OgnevOA/openprinttag_dryer_scale/hardware/carrier/netlist.md

# Carrier board netlist

Generated by `generate_netlist.py`. Do not edit by hand.

| Net | Connections |
| --- | --- |
| `+3V3` | C4.1, C5.1, C9.1, J3.10 +3V3, J4.1 +3V3, R10.2, R11.2, R13.2, R14.2, U1.12 3V3, U2.16 DVDD |
| `+5V` | C1.1, C2.1, C3.1, D1.1 K, D2.2 A, J3.1 +5V, Q1.3 C, U1.14 5V, U2.1 VSUP |
| `AGND` | C6.2, C7.2, C8.2, C11.2, C12.2, J2.2 E-, R4.2, R5.1, TP2.1, U2.5 AGND, U2.14 XI, U2.9 INB-, U2.15 RATE, U2.10 INB+ |
| `AVDD` | C7.1, C8.1, J2.1 E+, Q1.2 E, R3.1, TP1.1, U2.3 AVDD |
| `CELL_SIG+` | J2.3 SIG+, R6.1 |
| `CELL_SIG-` | J2.4 SIG-, R7.1 |
| `GND` | C1.2, C2.2, C3.2, C4.2, C5.2, C9.2, C13.2, D3.3 GND, J1.A12 GND, J1.B1 GND, J1.A1 GND, J1.B12 GND, J1.S1 SHIELD, J3.2 GND, J3.4 GND, J4.2 GND, R1.2, R2.2, R5.2, U1.13 GND |
| `HX_BASE` | Q1.1 B, U2.2 BASE |
| `HX_DOUT` | U1.1 D0/GPIO0, U2.12 DOUT |
| `HX_INA+` | C10.1, C11.1, R6.2, U2.8 INA+ |
| `HX_INA-` | C10.2, C12.1, R7.2, U2.7 INA- |
| `HX_SCK` | U1.2 D1/GPIO1, U2.11 PD_SCK |
| `HX_VBG` | C6.1, U2.6 VBG |
| `HX_VFB` | R3.2, R4.1, U2.4 VFB |
| `I2C_SCL` | J4.4 SCL, R14.1, U1.6 D5/GPIO23 |
| `I2C_SDA` | J4.3 SDA, R13.1, U1.5 D4/GPIO22 |
| `LED_DATA` | R12.1, U1.3 D2/GPIO2 |
| `LED_DATA_R` | D3.4 DIN, R12.2 |
| `NFC_BUSY` | J3.8 BUSY, U1.7 D6/GPIO16 |
| `NFC_NSS` | J3.7 NSS, R10.1, U1.4 D3/GPIO21 |
| `NFC_RST` | J3.9 RST, R11.1, U1.8 D7/GPIO17 |
| `SPI_MISO` | J3.6 MISO, U1.10 D9/GPIO20 |
| `SPI_MOSI` | R9.1, U1.11 D10/GPIO18 |
| `SPI_MOSI_R` | J3.5 MOSI, R9.2 |
| `SPI_SCK` | R8.1, U1.9 D8/GPIO19 |
| `SPI_SCK_R` | J3.3 SCK, R8.2 |
| `USB_CC1` | J1.A5 CC1, R1.1 |
| `USB_CC2` | J1.B5 CC2, R2.1 |
| `USB_VBUS_RAW` | F1.1, J1.A4 VBUS, J1.A9 VBUS, J1.B4 VBUS, J1.B9 VBUS |
| `VBUS` | D1.2 A, F1.2 |
| `VLED` | C13.1, D2.1 K, D3.1 VDD |

| Part | Value | Footprint |
| --- | --- | --- |
| C1 | 220u/10V | `Capacitor_SMD:CP_Elec_6.3x7.7` |
| C2 | 10u | `Capacitor_SMD:C_0603_1608Metric` |
| C3 | 100n | `Capacitor_SMD:C_0603_1608Metric` |
| C4 | 10u | `Capacitor_SMD:C_0603_1608Metric` |
| C5 | 100n | `Capacitor_SMD:C_0603_1608Metric` |
| C6 | 100n | `Capacitor_SMD:C_0603_1608Metric` |
| C7 | 10u | `Capacitor_SMD:C_0603_1608Metric` |
| C8 | 100n | `Capacitor_SMD:C_0603_1608Metric` |
| C9 | 100n | `Capacitor_SMD:C_0603_1608Metric` |
| C10 | 100n | `Capacitor_SMD:C_0603_1608Metric` |
| C11 | 10n | `Capacitor_SMD:C_0603_1608Metric` |
| C12 | 10n | `Capacitor_SMD:C_0603_1608Metric` |
| C13 | 100n | `Capacitor_SMD:C_0603_1608Metric` |
| D1 | SS34 | `Diode_SMD:D_SMA` |
| D2 | 1N4148W | `Diode_SMD:D_SOD-123` |
| D3 | WS2812B | `LED_SMD:LED_WS2812B_PLCC4_5.0x5.0mm_P3.2mm` |
| F1 | 500mA | `Fuse:Fuse_1206_3216Metric` |
| J1 | USB-C receptacle | `Connector_USB:USB_C_Receptacle_HRO_TYPE-C-31-M-12` |
| J2 | Load cell | `TerminalBlock:TerminalBlock_bornier-4_P5.08mm` |
| J3 | PN5180 ribbon | `Connector_IDC:IDC-Header_2x05_P2.54mm_Vertical` |
| J4 | Temp sensor | `Connector_PinHeader_2.54mm:PinHeader_1x04_P2.54mm_Vertical` |
| Q1 | BC817-40 | `Package_TO_SOT_SMD:SOT-23` |
| R1 | 5k1 | `Resistor_SMD:R_0603_1608Metric` |
| R2 | 5k1 | `Resistor_SMD:R_0603_1608Metric` |
| R3 | 20k | `Resistor_SMD:R_0603_1608Metric` |
| R4 | 8k2 | `Resistor_SMD:R_0603_1608Metric` |
| R5 | 0R | `Resistor_SMD:R_1206_3216Metric` |
| R6 | 1k | `Resistor_SMD:R_0603_1608Metric` |
| R7 | 1k | `Resistor_SMD:R_0603_1608Metric` |
| R8 | 33R | `Resistor_SMD:R_0603_1608Metric` |
| R9 | 33R | `Resistor_SMD:R_0603_1608Metric` |
| R10 | 10k | `Resistor_SMD:R_0603_1608Metric` |
| R11 | 10k | `Resistor_SMD:R_0603_1608Metric` |
| R12 | 330R | `Resistor_SMD:R_0603_1608Metric` |
| R13 | 4k7 | `Resistor_SMD:R_0603_1608Metric` |
| R14 | 4k7 | `Resistor_SMD:R_0603_1608Metric` |
| TP1 | AVDD | `TestPoint:TestPoint_Pad_D1.5mm` |
| TP2 | AGND | `TestPoint:TestPoint_Pad_D1.5mm` |
| U1 | XIAO ESP32-C6 | `Seeed_XIAO:XIAO_ESP32C6` |
| U2 | HX711 | `Package_SO:SOIC-16W_7.5x10.3mm_P1.27mm` |
