OgnevOA/openprinttag_dryer_scale/mechanical/preview/antenna_clamp.png

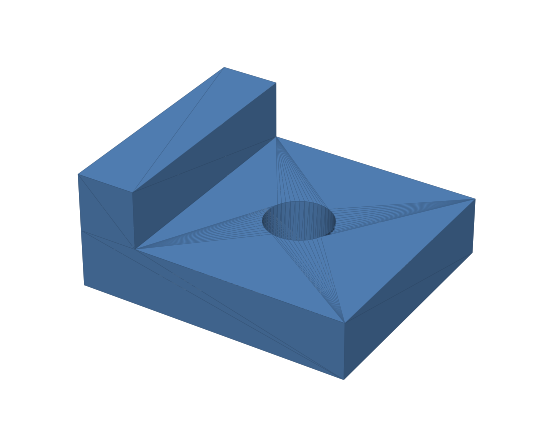
mechanical/preview/antenna_clamp.png
