OgnevOA/openprinttag_dryer_scale/mechanical/preview/cell_mount.png

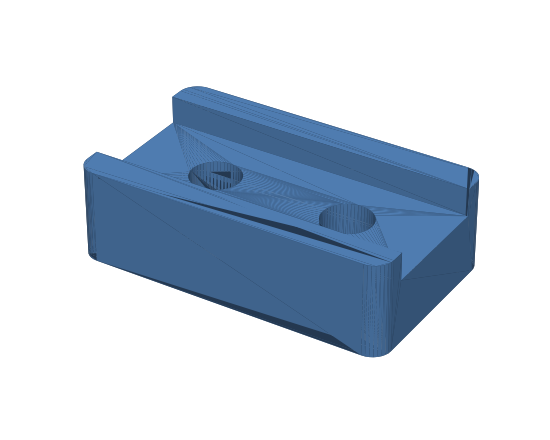
mechanical/preview/cell_mount.png
