OgnevOA/openprinttag_dryer_scale/mechanical/preview/overload_stop.png

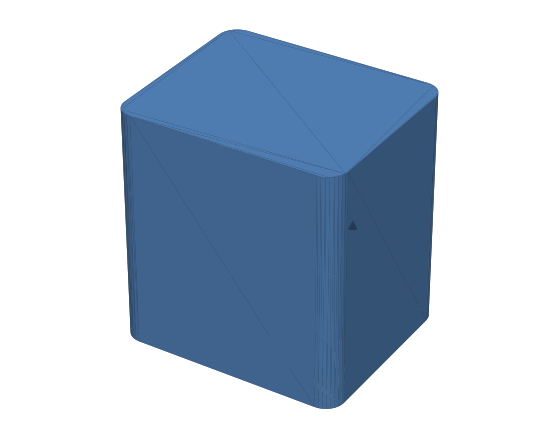
mechanical/preview/overload_stop.png
