OgnevOA/openprinttag_dryer_scale/mechanical/stl/cell_mount.stl

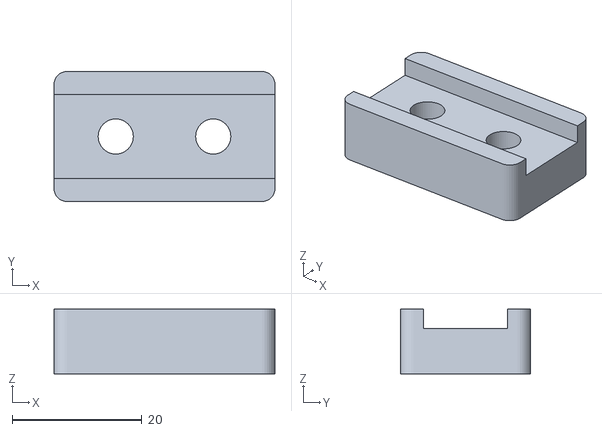
[picture p6: CAD file, 2026-11-01]
mechanical/stl/cell_mount.stl
34.0 x 20.0 x 10.0
