OgnevOA/openprinttag_dryer_scale/mechanical/stl/antenna_bracket.stl

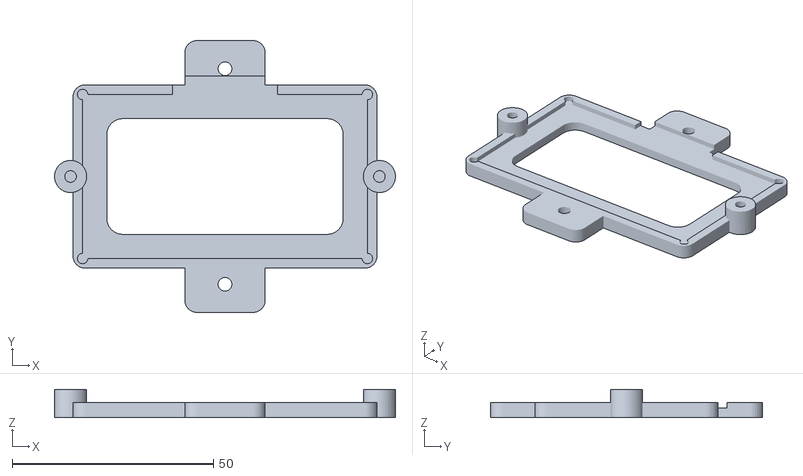
[picture p7: CAD file, 2026-11-01]
mechanical/stl/antenna_bracket.stl
84.8 x 67.6 x 7.00
