OgnevOA/openprinttag_dryer_scale/mechanical/stl/isolator_foot.stl

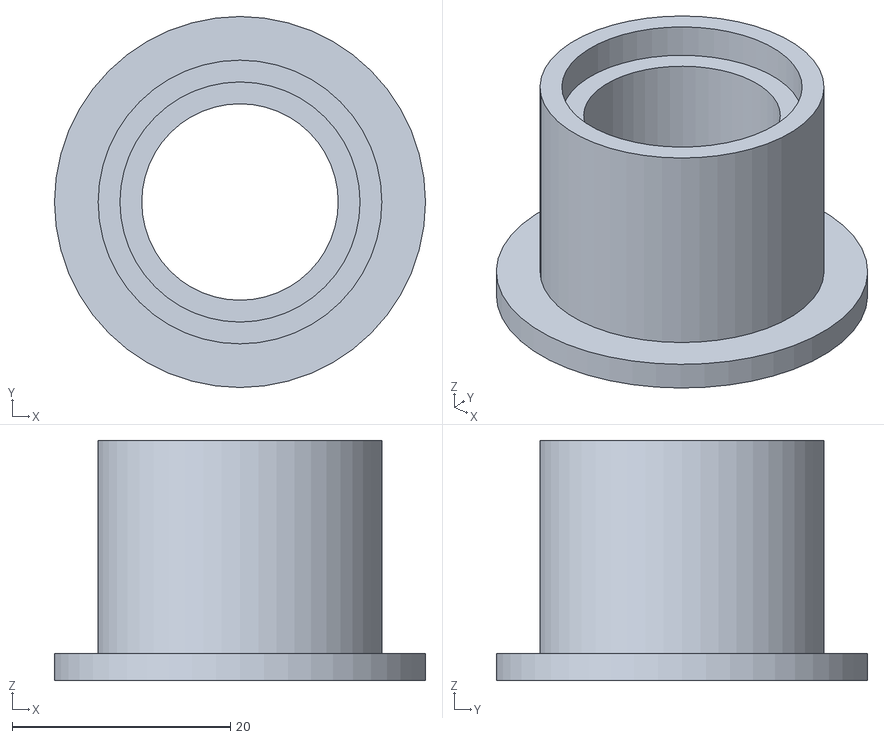
[picture p8: CAD file, 2026-11-01]
mechanical/stl/isolator_foot.stl
34.0 x 34.0 x 22.0
