OgnevOA/openprinttag_dryer_scale/mechanical/stl/overload_stop.stl

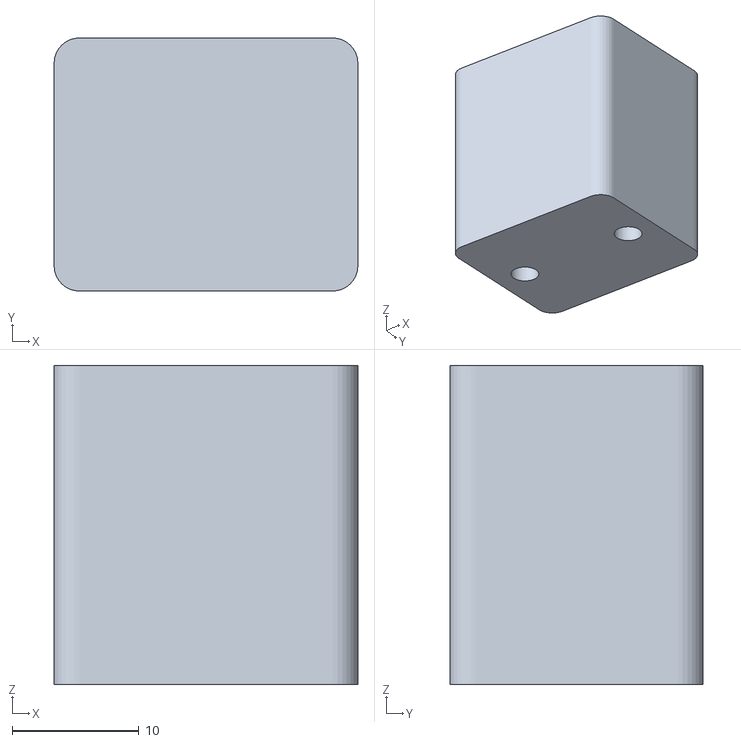
[picture p9: CAD file, 2026-11-01]
mechanical/stl/overload_stop.stl
24.0 x 20.0 x 25.2
