OgnevOA/openprinttag_dryer_scale/mechanical/stl/antenna_clamp.stl

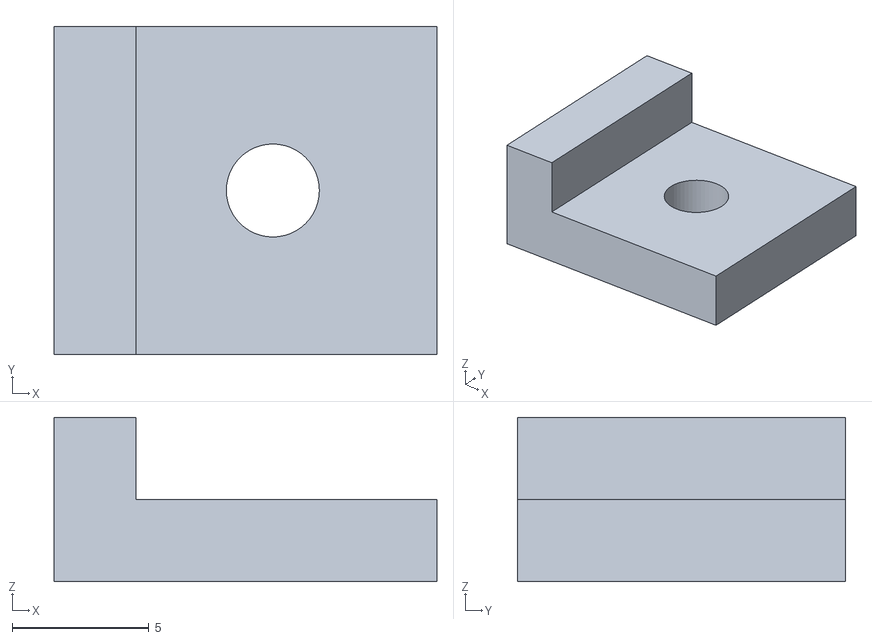
[picture p10: CAD file, 2026-11-01]
mechanical/stl/antenna_clamp.stl
14.0 x 12.0 x 6.00
