OgnevOA/openprinttag_dryer_scale/firmware/OpenPrintTagDryer/src/pn5180/PN5180.cpp

// NAME: PN5180.cpp
//
// DESC: Implementation of PN5180 class.
//
// Copyright (c) 2018 by Andreas Trappmann. All rights reserved.
//
// This file is part of the PN5180 library for the Arduino environment.
//
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
//#define DEBUG 1

#include <Arduino.h>
#include "PN5180.h"
#include "Debug.h"

// PN5180 1-Byte Direct Commands
// see 11.4.3.3 Host Interface Command List
#define PN5180_WRITE_REGISTER           (0x00)
#define PN5180_WRITE_REGISTER_OR_MASK   (0x01)
#define PN5180_WRITE_REGISTER_AND_MASK  (0x02)
#define PN5180_READ_REGISTER            (0x04)
#define PN5180_WRITE_EEPROM             (0x06)
#define PN5180_READ_EEPROM              (0x07)
#define PN5180_SEND_DATA                (0x09)
#define PN5180_READ_DATA                (0x0A)
#define PN5180_SWITCH_MODE              (0x0B)
#define PN5180_LOAD_RF_CONFIG           (0x11)
#define PN5180_RF_ON                    (0x16)
#define PN5180_RF_OFF                   (0x17)

uint8_t PN5180::readBuffer[508];

PN5180::PN5180(uint8_t SSpin, uint8_t BUSYpin, uint8_t RSTpin) {
  PN5180_NSS = SSpin;
  PN5180_BUSY = BUSYpin;
  PN5180_RST = RSTpin;

  /*
   * 11.4.1 Physical Host Interface
   * The interface of the PN5180 to a host microcontroller is based on a SPI interface,
   * extended by signal line BUSY. The maximum SPI speed is 7 Mbps and fixed to CPOL
   * = 0 and CPHA = 0.
   */
  // Settings for PN5180: 7Mbps, MSB first, SPI_MODE0 (CPOL=0, CPHA=0)
  PN5180_SPI_SETTINGS = SPISettings(7000000, MSBFIRST, SPI_MODE0);
}

void PN5180::begin(int8_t sckPin, int8_t misoPin, int8_t mosiPin,
                   uint32_t clockHz) {
  pinMode(PN5180_NSS, OUTPUT);
  pinMode(PN5180_BUSY, INPUT);
  pinMode(PN5180_RST, OUTPUT);

  digitalWrite(PN5180_NSS, HIGH); // disable
  digitalWrite(PN5180_RST, HIGH); // no reset

  PN5180_SPI_SETTINGS = SPISettings(clockHz, MSBFIRST, SPI_MODE0);

  if (sckPin >= 0 && misoPin >= 0 && mosiPin >= 0) {
    // Chip select stays under our own control, hence -1 for the SS argument.
    SPI.begin(sckPin, misoPin, mosiPin, -1);
  } else {
    SPI.begin();
  }
  PN5180DEBUG(F("SPI pinout: "));
  PN5180DEBUG(F("SS=")); PN5180DEBUG(SS);
  PN5180DEBUG(F(", MOSI=")); PN5180DEBUG(MOSI);
  PN5180DEBUG(F(", MISO=")); PN5180DEBUG(MISO);
  PN5180DEBUG(F(", SCK=")); PN5180DEBUG(SCK);
  PN5180DEBUG("\n");
}

void PN5180::end() {
  digitalWrite(PN5180_NSS, HIGH); // disable
  SPI.end();
}

/*
 * WRITE_REGISTER - 0x00
 * This command is used to write a 32-bit value (little endian) to a configuration register.
 * The address of the register must exist. If the condition is not fulfilled, an exception is
 * raised.
 */
bool PN5180::writeRegister(uint8_t reg, uint32_t value) {
  uint8_t *p = (uint8_t*)&value;

#ifdef DEBUG
  PN5180DEBUG(F("Write Register 0x"));
  PN5180DEBUG(formatHex(reg));
  PN5180DEBUG(F(", value (LSB first)=0x"));
  for (int i=0; i<4; i++) {
    PN5180DEBUG(formatHex(p[i]));
  }
  PN5180DEBUG("\n");
#endif

  /*
  For all 4 byte command parameter transfers (e.g. register values), the payload
  parameters passed follow the little endian approach (Least Significant Byte first).
   */
  uint8_t buf[6] = { PN5180_WRITE_REGISTER, reg, p[0], p[1], p[2], p[3] };

  SPI.beginTransaction(PN5180_SPI_SETTINGS);
  transceiveCommand(buf, 6);
  SPI.endTransaction();

  return true;
}

/*
 * WRITE_REGISTER_OR_MASK - 0x01
 * This command modifies the content of a register using a logical OR operation. The
 * content of the register is read and a logical OR operation is performed with the provided
 * mask. The modified content is written back to the register.
 * The address of the register must exist. If the condition is not fulfilled, an exception is
 * raised.
 */
bool PN5180::writeRegisterWithOrMask(uint8_t reg, uint32_t mask) {
  uint8_t *p = (uint8_t*)&mask;

#ifdef DEBUG
  PN5180DEBUG(F("Write Register 0x"));
  PN5180DEBUG(formatHex(reg));
  PN5180DEBUG(F(" with OR mask (LSB first)=0x"));
  for (int i=0; i<4; i++) {
    PN5180DEBUG(formatHex(p[i]));
  }
  PN5180DEBUG("\n");
#endif

  uint8_t buf[6] = { PN5180_WRITE_REGISTER_OR_MASK, reg, p[0], p[1], p[2], p[3] };

  SPI.beginTransaction(PN5180_SPI_SETTINGS);
  transceiveCommand(buf, 6);
  SPI.endTransaction();

  return true;
}

/*
 * WRITE _REGISTER_AND_MASK - 0x02
 * This command modifies the content of a register using a logical AND operation. The
 * content of the register is read and a logical AND operation is performed with the provided
 * mask. The modified content is written back to the register.
 * The address of the register must exist. If the condition is not fulfilled, an exception is
 * raised.
 */
bool PN5180::writeRegisterWithAndMask(uint8_t reg, uint32_t mask) {
  uint8_t *p = (uint8_t*)&mask;

#ifdef DEBUG
  PN5180DEBUG(F("Write Register 0x"));
  PN5180DEBUG(formatHex(reg));
  PN5180DEBUG(F(" with AND mask (LSB first)=0x"));
  for (int i=0; i<4; i++) {
    PN5180DEBUG(formatHex(p[i]));
  }
  PN5180DEBUG("\n");
#endif

  uint8_t buf[6] = { PN5180_WRITE_REGISTER_AND_MASK, reg, p[0], p[1], p[2], p[3] };

  SPI.beginTransaction(PN5180_SPI_SETTINGS);
  transceiveCommand(buf, 6);
  SPI.endTransaction();

  return true;
}

/*
 * READ_REGISTER - 0x04
 * This command is used to read the content of a configuration register. The content of the
 * register is returned in the 4 byte response.
 * The address of the register must exist. If the condition is not fulfilled, an exception is
 * raised.
 */
bool PN5180::readRegister(uint8_t reg, uint32_t *value) {
  PN5180DEBUG(F("Reading register 0x"));
  PN5180DEBUG(formatHex(reg));
  PN5180DEBUG(F("...\n"));

  uint8_t cmd[2] = { PN5180_READ_REGISTER, reg };

  SPI.beginTransaction(PN5180_SPI_SETTINGS);
  transceiveCommand(cmd, 2, (uint8_t*)value, 4);
  SPI.endTransaction();

  PN5180DEBUG(F("Register value=0x"));
  PN5180DEBUG(formatHex(*value));
  PN5180DEBUG("\n");

  return true;
}

/*
 * WRITE_EEPROM - 0x06
 */
 bool PN5180::writeEEPROM(uint8_t addr, uint8_t *data, int len) {
   if ((addr > 254) || ((addr+len) > 254)) {
     PN5180DEBUG(F("ERROR: Writing beyond addr 254!\n"));
     return false;
   }

   PN5180DEBUG(F("Writing to EEPROM at 0x"));
   PN5180DEBUG(formatHex(addr));
   PN5180DEBUG(F(", size="));
   PN5180DEBUG(len);
   PN5180DEBUG(F("...\n"));

   uint8_t buffer[len+2];
   buffer[0] = PN5180_WRITE_EEPROM;
   buffer[1] = addr;
   for (int i=0; i<len; i++) {
     buffer[2+i] = data[i];
   }

   SPI.beginTransaction(PN5180_SPI_SETTINGS);
   transceiveCommand(buffer, len+2);
   SPI.endTransaction();

   return true;
 }

/*
 * READ_EEPROM - 0x07
 * This command is used to read data from EEPROM memory area. The field 'Address'
 * indicates the start address of the read operation. The field Length indicates the number
 * of bytes to read. The response contains the data read from EEPROM (content of the
 * EEPROM); The data is read in sequentially increasing order starting with the given
 * address.
 * EEPROM Address must be in the range from 0 to 254, inclusive. Read operation must
 * not go beyond EEPROM address 254. If the condition is not fulfilled, an exception is
 * raised.
 */
bool PN5180::readEEprom(uint8_t addr, uint8_t *buffer, int len) {
  if ((addr > 254) || ((addr+len) > 254)) {
    PN5180DEBUG(F("ERROR: Reading beyond addr 254!\n"));
    return false;
  }

  PN5180DEBUG(F("Reading EEPROM at 0x"));
  PN5180DEBUG(formatHex(addr));
  PN5180DEBUG(F(", size="));
  PN5180DEBUG(len);
  PN5180DEBUG(F("...\n"));

  uint8_t cmd[3] = { PN5180_READ_EEPROM, addr, len };

  SPI.beginTransaction(PN5180_SPI_SETTINGS);
  transceiveCommand(cmd, 3, buffer, len);
  SPI.endTransaction();

#ifdef DEBUG
  PN5180DEBUG(F("EEPROM values: "));
  for (int i=0; i<len; i++) {
    PN5180DEBUG(formatHex(buffer[i]));
    PN5180DEBUG(" ");
  }
  PN5180DEBUG("\n");
#endif

  return true;
}

/*
 * SEND_DATA - 0x09
 * This command writes data to the RF transmission buffer and starts the RF transmission.
 * The parameter ‘Number of valid bits in last Byte’ indicates the exact number of bits to be
 * transmitted for the last byte (for non-byte aligned frames).
 * Precondition: Host shall configure the Transceiver by setting the register
 * SYSTEM_CONFIG.COMMAND to 0x3 before using the SEND_DATA command, as
 * the command SEND_DATA is only writing data to the transmission buffer and starts the
 * transmission but does not perform any configuration.
 * The size of ‘Tx Data’ field must be in the range from 0 to 260, inclusive (the 0 byte length
 * allows a symbol only transmission when the TX_DATA_ENABLE is cleared).‘Number of
 * valid bits in last Byte’ field must be in the range from 0 to 7. The command must not be
 * called during an ongoing RF transmission. Transceiver must be in ‘WaitTransmit’ state
 * with ‘Transceive’ command set. If the condition is not fulfilled, an exception is raised.
 */
bool PN5180::sendData(uint8_t *data, int len, uint8_t validBits) {
  if (len > 260) {
    PN5180DEBUG(F("ERROR: sendData with more than 260 bytes is not supported!\n"));
    return false;
  }

#ifdef DEBUG
  PN5180DEBUG(F("Send data (len="));
  PN5180DEBUG(len);
  PN5180DEBUG(F("):"));
  for (int i=0; i<len; i++) {
    PN5180DEBUG(" ");
    PN5180DEBUG(formatHex(data[i]));
  }
  PN5180DEBUG("\n");
#endif

  uint8_t buffer[len+2];
  buffer[0] = PN5180_SEND_DATA;
  buffer[1] = validBits; // number of valid bits of last byte are transmitted (0 = all bits are transmitted)
  for (int i=0; i<len; i++) {
    buffer[2+i] = data[i];
  }

  writeRegisterWithAndMask(SYSTEM_CONFIG, 0xfffffff8);  // Idle/StopCom Command
  writeRegisterWithOrMask(SYSTEM_CONFIG, 0x00000003);   // Transceive Command
  /*
   * Transceive command; initiates a transceive cycle.
   * Note: Depending on the value of the Initiator bit, a
   * transmission is started or the receiver is enabled
   * Note: The transceive command does not finish
   * automatically. It stays in the transceive cycle until
   * stopped via the IDLE/StopCom command
   */

  PN5180TransceiveStat transceiveState = getTransceiveState();
  if (PN5180_TS_WaitTransmit != transceiveState) {
    PN5180DEBUG(F("*** ERROR: Transceiver not in state WaitTransmit!?\n"));
    return false;
  }

  SPI.beginTransaction(PN5180_SPI_SETTINGS);
  transceiveCommand(buffer, len+2);
  SPI.endTransaction();

  return true;
}

/*
 * READ_DATA - 0x0A
 * This command reads data from the RF reception buffer, after a successful reception.
 * The RX_STATUS register contains the information to verify if the reception had been
 * successful. The data is available within the response of the command. The host controls
 * the number of bytes to be read via the SPI interface.
 * The RF data had been successfully received. In case the instruction is executed without
 * preceding an RF data reception, no exception is raised but the data read back from the
 * reception buffer is invalid. If the condition is not fulfilled, an exception is raised.
 */
uint8_t * PN5180::readData(int len, uint8_t *buffer /* = NULL */) {
  if (len > 508) {
    Serial.println(F("*** FATAL: Reading more than 508 bytes is not supported!"));
    return 0L;
  }
  if (NULL == buffer) {
    buffer = readBuffer;
  }

  PN5180DEBUG(F("Reading Data (len="));
  PN5180DEBUG(len);
  PN5180DEBUG(F(")...\n"));

  uint8_t cmd[2] = { PN5180_READ_DATA, 0x00 };

  SPI.beginTransaction(PN5180_SPI_SETTINGS);
  transceiveCommand(cmd, 2, buffer, len);
  SPI.endTransaction();

#ifdef DEBUG
  PN5180DEBUG(F("Data read: "));
  for (int i=0; i<len; i++) {
    PN5180DEBUG(formatHex(buffer[i]));
    PN5180DEBUG(" ");
  }
  PN5180DEBUG("\n");
#endif

  return readBuffer;
}

/*
 * LOAD_RF_CONFIG - 0x11
 * Parameter 'Transmitter Configuration' must be in the range from 0x0 - 0x1C, inclusive. If
 * the transmitter parameter is 0xFF, transmitter configuration is not changed.
 * Field 'Receiver Configuration' must be in the range from 0x80 - 0x9C, inclusive. If the
 * receiver parameter is 0xFF, the receiver configuration is not changed. If the condition is
 * not fulfilled, an exception is raised.
 * The transmitter and receiver configuration shall always be configured for the same
 * transmission/reception speed. No error is returned in case this condition is not taken into
 * account.
 *
 * Transmitter: RF   Protocol          Speed     Receiver: RF    Protocol    Speed
 * configuration                       (kbit/s)  configuration               (kbit/s)
 * byte (hex)                                    byte (hex)
 * ----------------------------------------------------------------------------------------------
 * ->0D              ISO 15693 ASK100  26        8D              ISO 15693   26
 *   0E              ISO 15693 ASK10   26        8E              ISO 15693   53
 */
bool PN5180::loadRFConfig(uint8_t txConf, uint8_t rxConf) {
  PN5180DEBUG(F("Load RF-Config: txConf="));
  PN5180DEBUG(formatHex(txConf));
  PN5180DEBUG(F(", rxConf="));
  PN5180DEBUG(formatHex(rxConf));
  PN5180DEBUG("\n");

  uint8_t cmd[3] = { PN5180_LOAD_RF_CONFIG, txConf, rxConf };

  SPI.beginTransaction(PN5180_SPI_SETTINGS);
  transceiveCommand(cmd, 3);
  SPI.endTransaction();

  return true;
}

/*
 * RF_ON - 0x16
 * This command is used to switch on the internal RF field. If enabled the TX_RFON_IRQ is
 * set after the field is switched on.
 */
bool PN5180::setRF_on() {
  PN5180DEBUG(F("Set RF ON\n"));

  uint8_t cmd[2] = { PN5180_RF_ON, 0x00 };

  SPI.beginTransaction(PN5180_SPI_SETTINGS);
  transceiveCommand(cmd, 2);
  SPI.endTransaction();

  if (!waitForIRQ(TX_RFON_IRQ_STAT)) return false; // wait for the field to set up
  clearIRQStatus(TX_RFON_IRQ_STAT);
  return true;
}

/*
 * RF_OFF - 0x17
 * This command is used to switch off the internal RF field. If enabled, the TX_RFOFF_IRQ
 * is set after the field is switched off.
 */
bool PN5180::setRF_off() {
  PN5180DEBUG(F("Set RF OFF\n"));

  uint8_t cmd[2] { PN5180_RF_OFF, 0x00 };

  SPI.beginTransaction(PN5180_SPI_SETTINGS);
  transceiveCommand(cmd, 2);
  SPI.endTransaction();

  if (!waitForIRQ(TX_RFOFF_IRQ_STAT)) return false; // wait for the field to shut down
  clearIRQStatus(TX_RFOFF_IRQ_STAT);
  return true;
}

//---------------------------------------------------------------------------------------------

/*
11.4.3.1 A Host Interface Command consists of either 1 or 2 SPI frames depending whether the
host wants to write or read data from the PN5180. An SPI Frame consists of multiple
bytes.

All commands are packed into one SPI Frame. An SPI Frame consists of multiple bytes.
No NSS toggles allowed during sending of an SPI frame.

For all 4 byte command parameter transfers (e.g. register values), the payload
parameters passed follow the little endian approach (Least Significant Byte first).

Direct Instructions are built of a command code (1 Byte) and the instruction parameters
(max. 260 bytes). The actual payload size depends on the instruction used.
Responses to direct instructions contain only a payload field (no header).
All instructions are bound to conditions. If at least one of the conditions is not fulfilled, an exception is
raised. In case of an exception, the IRQ line of PN5180 is asserted and corresponding interrupt
status register contain information on the exception.
*/

/*
 * A Host Interface Command consists of either 1 or 2 SPI frames depending whether the
 * host wants to write or read data from the PN5180. An SPI Frame consists of multiple
 * bytes.
 * All commands are packed into one SPI Frame. An SPI Frame consists of multiple bytes.
 * No NSS toggles allowed during sending of an SPI frame.
 * For all 4 byte command parameter transfers (e.g. register values), the payload
 * parameters passed follow the little endian approach (Least Significant Byte first).
 * The BUSY line is used to indicate that the system is BUSY and cannot receive any data
 * from a host. Recommendation for the BUSY line handling by the host:
 * 1. Assert NSS to Low
 * 2. Perform Data Exchange
 * 3. Wait until BUSY is high
 * 4. Deassert NSS
 * 5. Wait until BUSY is low
 * If there is a parameter error, the IRQ is set to ACTIVE and a GENERAL_ERROR_IRQ is set.
 */
bool PN5180::transceiveCommand(uint8_t *sendBuffer, size_t sendBufferLen, uint8_t *recvBuffer, size_t recvBufferLen) {
#ifdef DEBUG
  PN5180DEBUG(F("Sending SPI frame: '"));
  for (uint8_t i=0; i<sendBufferLen; i++) {
    if (i>0) PN5180DEBUG(" ");
    PN5180DEBUG(formatHex(sendBuffer[i]));
  }
  PN5180DEBUG("'\n");
#endif

  // 0.
  if (!waitBusy(LOW)) return false; // wait until busy is low
  // 1.
  digitalWrite(PN5180_NSS, LOW); delay(2);
  // 2.
  for (uint8_t i=0; i<sendBufferLen; i++) {
    SPI.transfer(sendBuffer[i]);
  }
  // 3.
  if (!waitBusy(HIGH)) { digitalWrite(PN5180_NSS, HIGH); return false; }
  // 4.
  digitalWrite(PN5180_NSS, HIGH); delay(1);
  // 5.
  if (!waitBusy(LOW)) return false; // wait until BUSY is low

  // check, if write-only
  //
  if ((0 == recvBuffer) || (0 == recvBufferLen)) return true;
  PN5180DEBUG(F("Receiving SPI frame...\n"));

  // 1.
  digitalWrite(PN5180_NSS, LOW); delay(2);
  // 2.
  for (uint8_t i=0; i<recvBufferLen; i++) {
    recvBuffer[i] = SPI.transfer(0xff);
  }
  // 3.
  if (!waitBusy(HIGH)) { digitalWrite(PN5180_NSS, HIGH); return false; }
  // 4.
  digitalWrite(PN5180_NSS, HIGH); delay(1);
  // 5.
  if (!waitBusy(LOW)) return false; // wait until BUSY is low

#ifdef DEBUG
  PN5180DEBUG(F("Received: "));
  for (uint8_t i=0; i<recvBufferLen; i++) {
    if (i > 0) PN5180DEBUG(" ");
    PN5180DEBUG(formatHex(recvBuffer[i]));
  }
  PN5180DEBUG("'\n");
#endif

  return true;
}

/*
 * Waits for the BUSY line to reach the requested level, giving up after
 * `timeoutMs`. Local addition: see the modification note in PN5180.h.
 */
bool PN5180::waitBusy(int level, uint32_t timeoutMs) {
  const uint32_t deadline = millis() + timeoutMs;
  while (level != digitalRead(PN5180_BUSY)) {
    if ((int32_t)(millis() - deadline) >= 0) {
      lastTimeout = true;
      return false;
    }
  }
  return true;
}

bool PN5180::waitForIRQ(uint32_t mask, uint32_t timeoutMs) {
  const uint32_t deadline = millis() + timeoutMs;
  while (mask != (mask & getIRQStatus())) {
    if ((int32_t)(millis() - deadline) >= 0) {
      lastTimeout = true;
      return false;
    }
    delay(1);
  }
  return true;
}

/*
 * Reset NFC device
 */
bool PN5180::reset() {
  lastTimeout = false;
  digitalWrite(PN5180_RST, LOW);  // at least 10us required
  delay(10);
  digitalWrite(PN5180_RST, HIGH); // 2ms to ramp up required
  delay(10);

  if (!waitForIRQ(IDLE_IRQ_STAT)) return false; // wait for system to start up

  clearIRQStatus(0xffffffff); // clear all flags
  return true;
}

/**
 * @name  getInterrrupt
 * @desc  read interrupt status register and clear interrupt status
 */
uint32_t PN5180::getIRQStatus() {
  PN5180DEBUG(F("Read IRQ-Status register...\n"));

  uint32_t irqStatus;
  readRegister(IRQ_STATUS, &irqStatus);

  PN5180DEBUG(F("IRQ-Status=0x"));
  PN5180DEBUG(formatHex(irqStatus));
  PN5180DEBUG("\n");

  return irqStatus;
}

bool PN5180::clearIRQStatus(uint32_t irqMask) {
  PN5180DEBUG(F("Clear IRQ-Status with mask=x"));
  PN5180DEBUG(formatHex(irqMask));
  PN5180DEBUG("\n");

  return writeRegister(IRQ_CLEAR, irqMask);
}

/*
 * Get TRANSCEIVE_STATE from RF_STATUS register
 */
#ifdef DEBUG
extern void showIRQStatus(uint32_t);
#endif

PN5180TransceiveStat PN5180::getTransceiveState() {
  PN5180DEBUG(F("Get Transceive state...\n"));

  uint32_t rfStatus;
  if (!readRegister(RF_STATUS, &rfStatus)) {
#ifdef DEBUG
    showIRQStatus(getIRQStatus());
#endif
    PN5180DEBUG(F("ERROR reading RF_STATUS register.\n"));
    return PN5180TransceiveStat(0);
  }

  /*
   * TRANSCEIVE_STATEs:
   *  0 - idle
   *  1 - wait transmit
   *  2 - transmitting
   *  3 - wait receive
   *  4 - wait for data
   *  5 - receiving
   *  6 - loopback
   *  7 - reserved
   */
  uint8_t state = ((rfStatus >> 24) & 0x07);
  PN5180DEBUG(F("TRANSCEIVE_STATE=0x"));
  PN5180DEBUG(formatHex(state));
  PN5180DEBUG("\n");

  return PN5180TransceiveStat(state);
}
