OgnevOA/openprinttag_dryer_scale/firmware/OpenPrintTagDryer/src/pn5180/PN5180.h

// NAME: PN5180.h
//
// DESC: NFC Communication with NXP Semiconductors PN5180 module for Arduino.
//
// Copyright (c) 2018 by Andreas Trappmann. All rights reserved.
//
// This file is part of the PN5180 library for the Arduino environment.
//
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
// ---------------------------------------------------------------------------
// LOCAL MODIFICATIONS for the OpenPrintTag dryer project (see ../../../README):
//
//  * begin() takes explicit SPI pins and a clock rate, because the ESP32-C6
//    needs the bus routed to the XIAO header and the reader sits on a ribbon
//    cable that will not take 7 MHz.
//  * Every wait on the BUSY line and on an IRQ flag is bounded by a timeout.
//    Upstream spins forever, which turns an unplugged or unpowered reader into
//    a watchdog reboot loop on a permanently installed device.
//  * reset() reports success instead of returning void.
//
// These files remain LGPL-2.1; see COPYING.LESSER.
// ---------------------------------------------------------------------------
//
#ifndef PN5180_H
#define PN5180_H

#include <SPI.h>

// PN5180 Registers
#define SYSTEM_CONFIG       (0x00)
#define IRQ_ENABLE          (0x01)
#define IRQ_STATUS          (0x02)
#define IRQ_CLEAR           (0x03)
#define TRANSCEIVE_CONTROL  (0x04)
#define TIMER1_RELOAD       (0x0c)
#define TIMER1_CONFIG       (0x0f)
#define RX_WAIT_CONFIG      (0x11)
#define CRC_RX_CONFIG       (0x12)
#define RX_STATUS           (0x13)
#define CRC_TX_CONFIG       (0x19)
#define RF_STATUS           (0x1d)
#define SYSTEM_STATUS       (0x24)
#define TEMP_CONTROL        (0x25)

// PN5180 EEPROM Addresses
#define DIE_IDENTIFIER      (0x00)
#define PRODUCT_VERSION     (0x10)
#define FIRMWARE_VERSION    (0x12)
#define EEPROM_VERSION      (0x14)
#define IRQ_PIN_CONFIG      (0x1A)

enum PN5180TransceiveStat {
  PN5180_TS_Idle = 0,
  PN5180_TS_WaitTransmit = 1,
  PN5180_TS_Transmitting = 2,
  PN5180_TS_WaitReceive = 3,
  PN5180_TS_WaitForData = 4,
  PN5180_TS_Receiving = 5,
  PN5180_TS_LoopBack = 6,
  PN5180_TS_RESERVED = 7
};

// PN5180 IRQ_STATUS
#define RX_IRQ_STAT         (1<<0)  // End of RF rececption IRQ
#define TX_IRQ_STAT         (1<<1)  // End of RF transmission IRQ
#define IDLE_IRQ_STAT       (1<<2)  // IDLE IRQ
#define RFOFF_DET_IRQ_STAT  (1<<6)  // RF Field OFF detection IRQ
#define RFON_DET_IRQ_STAT   (1<<7)  // RF Field ON detection IRQ
#define TX_RFOFF_IRQ_STAT   (1<<8)  // RF Field OFF in PCD IRQ
#define TX_RFON_IRQ_STAT    (1<<9)  // RF Field ON in PCD IRQ
#define RX_SOF_DET_IRQ_STAT (1<<14) // RF SOF Detection IRQ

class PN5180 {
private:
  uint8_t PN5180_NSS;   // active low
  uint8_t PN5180_BUSY;
  uint8_t PN5180_RST;

  SPISettings PN5180_SPI_SETTINGS;
  static uint8_t readBuffer[508];

public:
  PN5180(uint8_t SSpin, uint8_t BUSYpin, uint8_t RSTpin);

  // Pass -1 for the pins to keep the board's default SPI mapping.
  void begin(int8_t sckPin = -1, int8_t misoPin = -1, int8_t mosiPin = -1,
             uint32_t clockHz = 7000000);
  void end();

  // How long any single wait on BUSY or on an IRQ flag may take before the
  // operation is abandoned. A healthy PN5180 answers in microseconds.
  static const uint32_t BUSY_TIMEOUT_MS = 50;
  static const uint32_t IRQ_TIMEOUT_MS = 100;

  // True when the last operation gave up waiting for the reader, which means
  // the reader is unreachable rather than the tag being absent.
  bool timedOut() const { return lastTimeout; }

  /*
   * PN5180 direct commands with host interface
   */
public:
  /* cmd 0x00 */
  bool writeRegister(uint8_t reg, uint32_t value);
  /* cmd 0x01 */
  bool writeRegisterWithOrMask(uint8_t addr, uint32_t mask);
  /* cmd 0x02 */
  bool writeRegisterWithAndMask(uint8_t addr, uint32_t mask);

  /* cmd 0x04 */
  bool readRegister(uint8_t reg, uint32_t *value);

  /* cmd 0x06 */
  bool writeEEPROM(uint8_t addr, uint8_t *data, int len);

  /* cmd 0x07 */
  bool readEEprom(uint8_t addr, uint8_t *buffer, int len);

  /* cmd 0x09 */
  bool sendData(uint8_t *data, int len, uint8_t validBits = 0);
  /* cmd 0x0a */
  uint8_t * readData(int len, uint8_t *buffer = NULL);

  /* cmd 0x11 */
  bool loadRFConfig(uint8_t txConf, uint8_t rxConf);

  /* cmd 0x16 */
  bool setRF_on();
  /* cmd 0x17 */
  bool setRF_off();

  /*
   * Helper functions
   */
public:
  bool reset();

  uint32_t getIRQStatus();
  bool clearIRQStatus(uint32_t irqMask);

  // Waits for every bit in `mask` to appear in IRQ_STATUS. False on timeout.
  bool waitForIRQ(uint32_t mask, uint32_t timeoutMs = IRQ_TIMEOUT_MS);

  PN5180TransceiveStat getTransceiveState();

  /*
   * Private methods, called within an SPI transaction
   */
protected:
  bool transceiveCommand(uint8_t *sendBuffer, size_t sendBufferLen, uint8_t *recvBuffer = 0, size_t recvBufferLen = 0);

  // Waits for BUSY to reach `level` (HIGH or LOW). False on timeout.
  bool waitBusy(int level, uint32_t timeoutMs = BUSY_TIMEOUT_MS);

  bool lastTimeout = false;

};

#endif /* PN5180_H */
