OgnevOA/openprinttag_dryer_scale/firmware/OpenPrintTagDryer/src/pn5180/PN5180ISO15693.h

// NAME: PN5180ISO15693.h
//
// DESC: ISO15693 protocol on NXP Semiconductors PN5180 module for Arduino.
//
// Copyright (c) 2018 by Andreas Trappmann. All rights reserved.
//
// This file is part of the PN5180 library for the Arduino environment.
//
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
// ---------------------------------------------------------------------------
// LOCAL MODIFICATIONS for the OpenPrintTag dryer project:
//
//  * The wait for a tag's response is bounded (ISO15693_RX_TIMEOUT_MS).
//  * issueISO15693Command is protected rather than private, so the project's
//    own subclass can add the Read Multiple Blocks command without forking the
//    whole file. Reading a 79-block tag one block at a time takes over a
//    second; in chunks it takes about a tenth of that.
//
// These files remain LGPL-2.1; see COPYING.LESSER.
// ---------------------------------------------------------------------------
//
#ifndef PN5180ISO15693_H
#define PN5180ISO15693_H

#include "PN5180.h"

// How long to wait for a tag to finish answering before treating it as gone.
#define ISO15693_RX_TIMEOUT_MS  (200)

enum ISO15693ErrorCode {
  EC_NO_CARD = -1,
  ISO15693_EC_OK = 0,
  ISO15693_EC_NOT_SUPPORTED = 0x01,
  ISO15693_EC_NOT_RECOGNIZED = 0x02,
  ISO15693_EC_OPTION_NOT_SUPPORTED = 0x03,
  ISO15693_EC_UNKNOWN_ERROR = 0x0f,
  ISO15693_EC_BLOCK_NOT_AVAILABLE = 0x10,
  ISO15693_EC_BLOCK_ALREADY_LOCKED = 0x11,
  ISO15693_EC_BLOCK_IS_LOCKED = 0x12,
  ISO15693_EC_BLOCK_NOT_PROGRAMMED = 0x13,
  ISO15693_EC_BLOCK_NOT_LOCKED = 0x14,
  ISO15693_EC_CUSTOM_CMD_ERROR = 0xA0
};

class PN5180ISO15693 : public PN5180 {

public:
  PN5180ISO15693(uint8_t SSpin, uint8_t BUSYpin, uint8_t RSTpin);
  
protected:
  ISO15693ErrorCode issueISO15693Command(uint8_t *cmd, uint8_t cmdLen, uint8_t **resultPtr);
public:
  ISO15693ErrorCode getInventory(uint8_t *uid);

  ISO15693ErrorCode readSingleBlock(uint8_t *uid, uint8_t blockNo, uint8_t *blockData, uint8_t blockSize);
  ISO15693ErrorCode writeSingleBlock(uint8_t *uid, uint8_t blockNo, uint8_t *blockData, uint8_t blockSize);

  ISO15693ErrorCode getSystemInfo(uint8_t *uid, uint8_t *blockSize, uint8_t *numBlocks);
   
  // ICODE SLIX2 specific commands, see https://www.nxp.com/docs/en/data-sheet/SL2S2602.pdf
  ISO15693ErrorCode getRandomNumber(uint8_t *randomData);
  ISO15693ErrorCode setPassword(uint8_t *password, uint8_t *random);
  ISO15693ErrorCode writePassword(uint8_t *password, uint8_t *uid);
  ISO15693ErrorCode enablePrivacy(uint8_t *password, uint8_t *random);
  ISO15693ErrorCode unlockICODESLIX2(uint8_t *password);
  ISO15693ErrorCode lockICODESLIX2(uint8_t *password);
  ISO15693ErrorCode newpasswordICODESLIX2(uint8_t *newpassword, uint8_t *oldpassword, uint8_t *uid);
  /*
   * Helper functions
   */
public:   
  bool setupRF();
  const __FlashStringHelper *strerror(ISO15693ErrorCode errno);
    
};

#endif /* PN5180ISO15693_H */
