OgnevOA/openprinttag_dryer_scale/tests/test_logic.cpp

// Host tests for the firmware logic that does not need a radio: the HX711
// driver against a simulated converter, the calibration and weight maths, the
// spool state derivation, the material presets, and the reader's behaviour when
// nothing answers on the SPI bus.

#include <ctype.h>
#include <math.h>
#include <stdio.h>
#include <stdlib.h>
#include <string.h>

#include <string>
#include <vector>

// The fake Spoolman lives behind the HTTP client stub, so the tests reach it
// the same way the firmware reaches the real one.
#include <HTTPClient.h>

#include "../firmware/OpenPrintTagDryer/src/App.h"
#include "../firmware/OpenPrintTagDryer/src/DriftLog.h"
#include "../firmware/OpenPrintTagDryer/src/Ds18b20.h"
#include "../firmware/OpenPrintTagDryer/src/HaMqtt.h"
#include "../firmware/OpenPrintTagDryer/src/NfcManager.h"
#include "../firmware/OpenPrintTagDryer/src/PrusamentPresets.h"
#include "../firmware/OpenPrintTagDryer/src/ScaleManager.h"
#include "../firmware/OpenPrintTagDryer/src/SpoolState.h"
#include "../firmware/OpenPrintTagDryer/src/SpoolmanClient.h"
#include "../firmware/OpenPrintTagDryer/src/WebPortal.h"
#include "../firmware/OpenPrintTagDryer/src/WriteBackPolicy.h"
#include "../firmware/OpenPrintTagDryer/src/openprinttag/opt_enums.h"

namespace {

int gChecks = 0;
int gFailures = 0;
const char *gCurrentTest = "";

void fail(const std::string &what, const std::string &detail) {
    ++gFailures;
    printf("  FAIL %s: %s\n        %s\n", gCurrentTest, what.c_str(),
           detail.c_str());
}

void check(bool condition, const std::string &what,
           const std::string &detail = "") {
    ++gChecks;
    if (!condition) {
        fail(what, detail);
    }
}

void checkEqualInt(long long actual, long long expected,
                   const std::string &what) {
    ++gChecks;
    if (actual != expected) {
        char buffer[128];
        snprintf(buffer, sizeof(buffer), "expected %lld, got %lld", expected,
                 actual);
        fail(what, buffer);
    }
}

void checkNear(double actual, double expected, double tolerance,
               const std::string &what) {
    ++gChecks;
    if (fabs(actual - expected) > tolerance) {
        char buffer[160];
        snprintf(buffer, sizeof(buffer), "expected %g +/- %g, got %g", expected,
                 tolerance, actual);
        fail(what, buffer);
    }
}

// Feeds the scale a steady value until it produces measurements.
void feedScale(ScaleManager &scale, long counts, int measurements) {
    hostio::setHx711Value(counts, true);
    int produced = 0;
    for (int guard = 0; guard < 20000 && produced < measurements; ++guard) {
        hostio::hx711().ready = true;  // a fresh conversion is always waiting
        if (scale.loop(hostio::now())) {
            ++produced;
        }
        hostio::advance(1);
    }
    check(produced == measurements, "scale produced the requested measurements",
          std::to_string(produced) + " of " + std::to_string(measurements));
}

void startScale(ScaleManager &scale) {
    hostio::attachHx711(PIN_HX711_DOUT, PIN_HX711_SCK);
    hostio::setHx711Value(100000, true);
    check(scale.begin(), "scale begins with a responding converter");
}

// ---------------------------------------------------------------------------

void testHx711Driver() {
    gCurrentTest = "hx711 driver";
    hostio::reset();

    ScaleManager scale;
    startScale(scale);

    // The driver must reproduce the converter's 24-bit two's complement output
    // exactly, including the sign, and clock a 25th pulse to keep channel A at
    // gain 128.
    struct Case {
        long value;
        const char *label;
    };
    const Case cases[] = {
        {123456, "positive mid-range"},
        {0x7FFFFF, "largest positive"},
        {-123456, "negative mid-range"},
        {-0x800000, "largest negative"},
    };

    for (const Case &testCase : cases) {
        hostio::setHx711Value(testCase.value, true);
        const uint32_t before = hostio::hx711().conversions;
        // 15 samples make one measurement; all of them read the same value.
        feedScale(scale, testCase.value, 1);
        checkEqualInt(scale.status().rawCounts, testCase.value, testCase.label);
        check(hostio::hx711().conversions > before,
              "the 25th pulse completed the conversion");
    }

    // A data line stuck high yields no samples rather than a wild reading.
    hostio::hx711().stuckHigh = true;
    const uint32_t measurementsBefore = scale.status().measurementCount;
    for (int i = 0; i < 200; ++i) {
        scale.loop(hostio::now());
        hostio::advance(10);
    }
    checkEqualInt(scale.status().measurementCount, measurementsBefore,
                  "no measurements from a stuck data line");
    hostio::hx711().stuckHigh = false;

    // A stuck-low line looks ready forever and clocks out nothing but zeros,
    // which the driver rejects as a fault rather than reporting as zero load.
    hostio::hx711().stuckLow = true;
    for (int i = 0; i < 50; ++i) {
        scale.loop(hostio::now());
        hostio::advance(10);
    }
    check(scale.status().sampleErrorCount > 0,
          "stuck-low data line counted as a sample error");
    hostio::hx711().stuckLow = false;
}

void testMedianFiltering() {
    gCurrentTest = "median filtering";
    hostio::reset();

    ScaleManager scale;
    startScale(scale);

    // A single wild sample in the middle of a window must not move the result.
    int samples = 0;
    bool gotMeasurement = false;
    for (int guard = 0; guard < 20000 && !gotMeasurement; ++guard) {
        hostio::hx711().ready = true;
        hostio::hx711().value = (samples == 7) ? 900000 : 100000;
        if (scale.loop(hostio::now())) {
            gotMeasurement = true;
        }
        ++samples;
        hostio::advance(1);
    }
    check(gotMeasurement, "measurement produced");
    checkEqualInt(scale.status().rawCounts, 100000,
                  "median rejected the outlier");
}

void testCalibrationAndPersistence() {
    gCurrentTest = "calibration";
    hostio::reset();

    char message[128] = {0};

    {
        ScaleManager scale;
        startScale(scale);

        // Empty platform.
        feedScale(scale, 100000, 6);
        check(scale.zeroPlatform(message, sizeof(message)), "zero the platform",
              message);
        checkNear(scale.status().zeroCounts, 100000, 1, "zero counts stored");

        // Span: 1000 g reads 21000 counts higher, so 21 counts per gram.
        feedScale(scale, 121000, 6);
        check(scale.calibrateSpan(1000.0f, message, sizeof(message)),
              "calibrate the span", message);
        checkNear(scale.status().countsPerGram, 21.0, 0.01,
                  "counts per gram from a known mass");
        checkNear(scale.gross(), 1000.0, 0.5, "known mass reads back");

        // Refusals: an implausible mass, and a mass that is not on the platform.
        check(!scale.calibrateSpan(10.0f, message, sizeof(message)),
              "tiny calibration mass refused");
        feedScale(scale, 100000, 6);
        check(!scale.calibrateSpan(1000.0f, message, sizeof(message)),
              "calibration with nothing on the platform refused");

        // Empty dryer: 1.14 kg, which becomes the tare.
        feedScale(scale, 100000 + static_cast<long>(1140 * 21), 6);
        check(scale.tareDryer(message, sizeof(message)), "tare the dryer",
              message);
        checkNear(scale.status().dryerTareGrams, 1140.0, 1.0,
                  "dryer tare stored");

        // A full spool on top: 1044 g filament plus a 201 g spool.
        feedScale(scale, 100000 + static_cast<long>((1140 + 1245) * 21), 6);
        checkNear(scale.gross(), 2385.0, 1.5, "gross weight");
        checkNear(scale.spoolGrams(), 1245.0, 1.5, "spool weight after tare");
    }

    // A new instance, as after a reboot, must find its calibration in NVS.
    {
        ScaleManager scale;
        hostio::setHx711Value(100000, true);
        check(scale.begin(), "scale begins after reboot");
        checkNear(scale.status().countsPerGram, 21.0, 0.01, "span restored");
        checkNear(scale.status().zeroCounts, 100000, 1, "zero restored");
        checkNear(scale.status().dryerTareGrams, 1140.0, 1.0, "tare restored");
        check(scale.status().calibrated, "calibrated flag restored");

        check(scale.setDryerTare(1150.0f, message, sizeof(message)),
              "tare can be set directly");
        checkNear(scale.status().dryerTareGrams, 1150.0, 0.01, "tare updated");
        check(!scale.setDryerTare(5.0f, message, sizeof(message)),
              "implausible tare refused");
    }
}

void testTemperatureCompensation() {
    gCurrentTest = "temperature compensation";
    hostio::reset();

    hostio::lm75().attached = true;
    hostio::lm75().address = 0x48;
    hostio::lm75().celsius = 22.0f;

    ScaleManager scale;
    startScale(scale);
    feedScale(scale, 100000, 6);
    char message[128] = {0};
    scale.zeroPlatform(message, sizeof(message));
    feedScale(scale, 121000, 6);
    scale.calibrateSpan(1000.0f, message, sizeof(message));

    check(scale.status().temperatureValid, "temperature sensor found");
    checkNear(scale.status().temperatureC, 22.0, 0.1, "temperature read");

    // Half a gram per degree: at 50 C that is 14 g of apparent extra weight,
    // which compensation should remove. The sensor is only polled every few
    // seconds, so the clock has to move for the new temperature to be seen.
    scale.setDriftPerC(0.5f);
    hostio::lm75().celsius = 50.0f;
    hostio::advance(6000);
    feedScale(scale, 121000, 8);
    checkNear(scale.status().temperatureC, 50.0, 0.1, "warm temperature read");
    checkNear(scale.status().driftCorrectionGrams, 14.0, 0.1,
              "drift correction");
    checkNear(scale.status().uncompensatedGrams, 1000.0, 0.5,
              "uncompensated reading");
    checkNear(scale.gross(), 986.0, 0.5, "compensated reading");

    // Losing the sensor must not apply a stale correction.
    hostio::lm75().failReads = true;
    hostio::advance(6000);
    feedScale(scale, 121000, 8);
    check(!scale.status().temperatureValid, "sensor loss noticed");
    checkNear(scale.status().driftCorrectionGrams, 0.0, 0.01,
              "no correction without a temperature");
}

void testStability() {
    gCurrentTest = "stability detection";
    hostio::reset();

    ScaleManager scale;
    startScale(scale);
    char message[128] = {0};
    feedScale(scale, 100000, 6);
    scale.zeroPlatform(message, sizeof(message));
    feedScale(scale, 121000, 6);
    scale.calibrateSpan(1000.0f, message, sizeof(message));

    feedScale(scale, 121000, 6);
    check(scale.stable(), "steady load reads as stable");

    // Alternating by 100 counts is about 5 g, well outside the band.
    bool sawUnstable = false;
    for (int i = 0; i < 8; ++i) {
        feedScale(scale, (i % 2 == 0) ? 121000 : 121400, 1);
        if (!scale.stable()) {
            sawUnstable = true;
        }
    }
    check(sawUnstable, "a moving load reads as unstable");

    feedScale(scale, 121000, 6);
    check(scale.stable(), "settles again once the load stops moving");
}

opt::OptTag makeTag(float fullWeight, float spoolWeight, float lengthMm,
                    bool haveConsumed, float consumed) {
    opt::OptTag tag;
    tag.main.hasActualNettoFullWeight = true;
    tag.main.actualNettoFullWeight = fullWeight;
    tag.main.hasEmptyContainerWeight = true;
    tag.main.emptyContainerWeight = spoolWeight;
    if (lengthMm > 0.0f) {
        tag.main.hasActualFullLength = true;
        tag.main.actualFullLength = lengthMm;
    }
    tag.main.hasDensity = true;
    tag.main.density = 1.24f;
    tag.main.hasFilamentDiameter = true;
    tag.main.filamentDiameter = 1.75f;
    tag.regions.hasAux = true;
    tag.aux.hasConsumedWeight = haveConsumed;
    tag.aux.consumedWeight = consumed;
    return tag;
}

ScaleManager::Status makeScale(float gross, float tare) {
    ScaleManager::Status status;
    status.online = true;
    status.haveReading = true;
    status.stable = true;
    status.grossGrams = gross;
    status.dryerTareGrams = tare;
    status.calibrated = true;
    return status;
}
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
